Dacilndak/2270-g121/report-titlepage.tex

\begin{titlepage}
\begin{center}

% Upper part of the page. The '~' is needed because \\
% only works if a paragraph has started.

\textsc{\Large UNIVERSITY OF COLORADO BOULDER}\\[1.5cm]

\textsc{\large ECEN 2270: ELECTRONICS DESIGN LAB FINAL REPORT}\\[0.5cm]

% Title
\HRule \\[0.4cm]
{ \LARGE \bfseries Movement Controlled Robot \\ [0.4cm] }

\HRule \\[1.5cm]

% Author and supervisor
\noindent
\begin{minipage}{0.4\textwidth}
\begin{flushleft} \large
Joseph \textsc{Blake}\\
Matthew \textsc{Haney}
\end{flushleft}
\end{minipage}%
\begin{minipage}{0.4\textwidth}
\begin{flushright} \large
Rachel \textsc{Lawson}\\
Milica \textsc{Notaros}
\end{flushright}
\end{minipage}\\[1.5cm]

\vfill

% Bottom of the page
{\large \today}

\end{center}

\end{titlepage}
