Dacilndak/2270-g121/intro.png

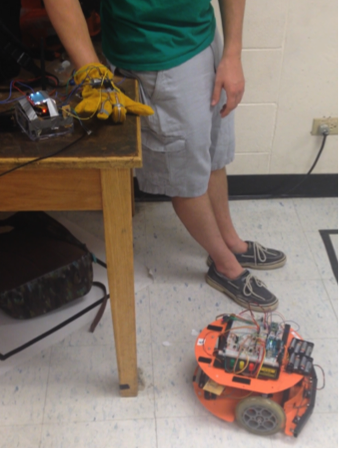
intro.png
