Dacilndak/2270-g121/triple.png

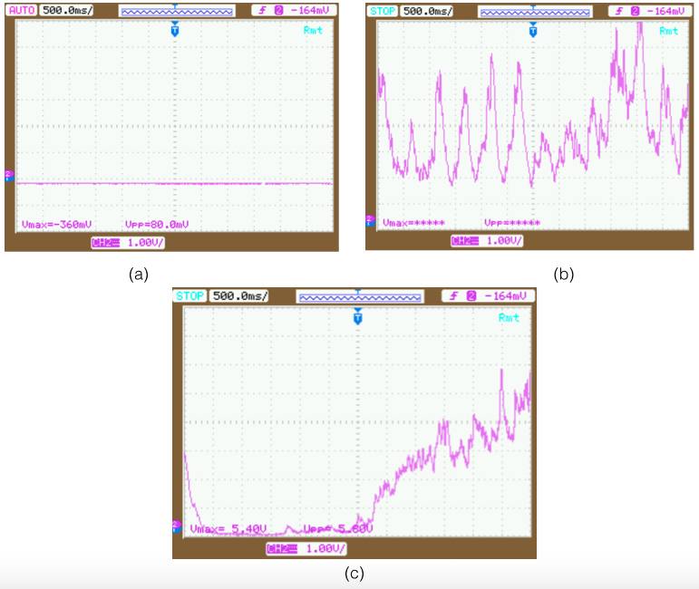
triple.png
